theBrutzler/HDMI_to_TTL/3D_Pictures/HDMI_example.png

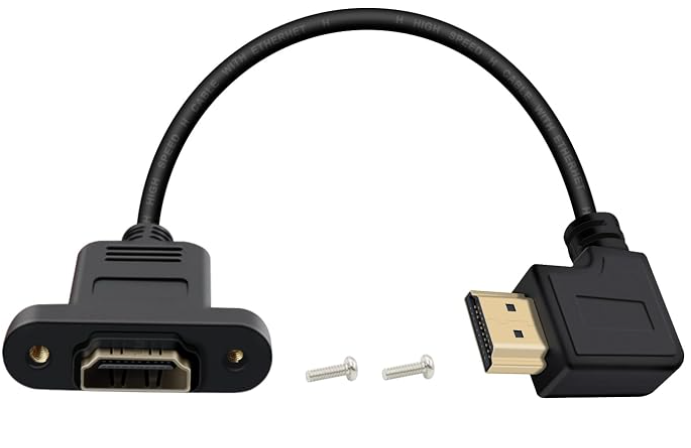
3D_Pictures/HDMI_example.png
