theBrutzler/HDMI_to_TTL/TTL_to_HDMI_DISPLAY.step

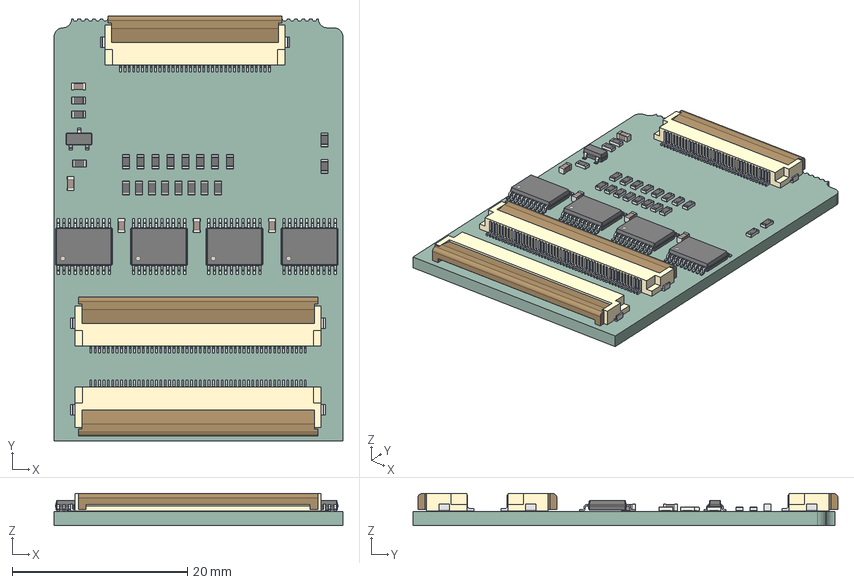
[picture p19: CAD file, 2026-10-30]
TTL_to_HDMI_DISPLAY.step
33.0 x 48.6 x 3.66 mm
C_0603_1608Metric x 5
TSSOP-20_4.4x6.5mm_P0.65mm x 4
R_0603_1608Metric x 21
lock x 3
pins x 3
SOT-23
TTL6087_PCB
