theBrutzler/HDMI_to_TTL/FH12-32S-0.5SH--3DModel-STEP-1.STEP

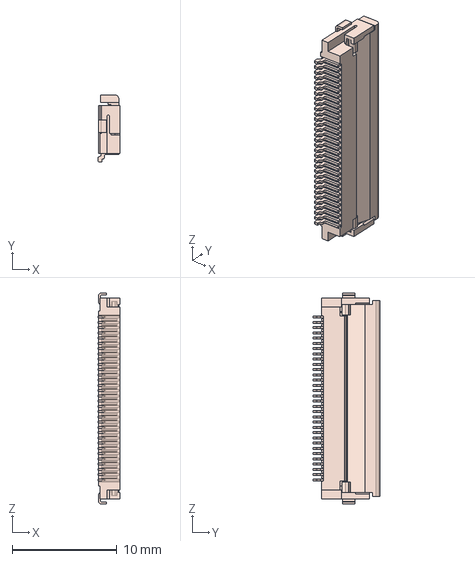
[picture p20: CAD file, 2024-02-11]
FH12-32S-0.5SH--3DModel-STEP-1.STEP
2.10 x 6.40 x 20.1 mm
