theBrutzler/HDMI_to_TTL/5-1734592-0.stp

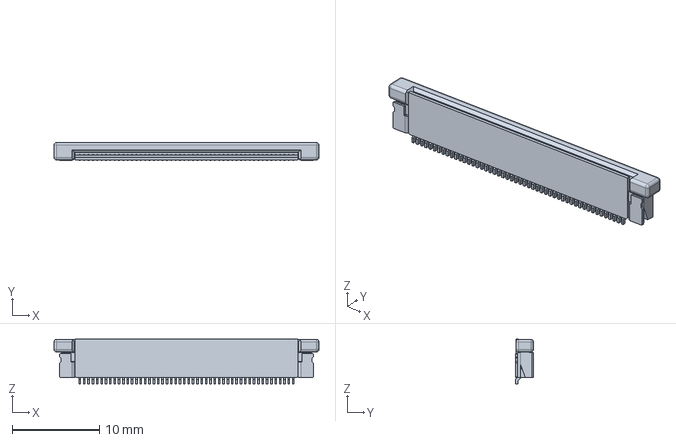
[picture p21: CAD file, 2022-11-29]
5-1734592-0.stp
30.4 x 2.05 x 5.11 mm
