theBrutzler/HDMI_to_TTL/Archiv/ds1000z_mainboard.step

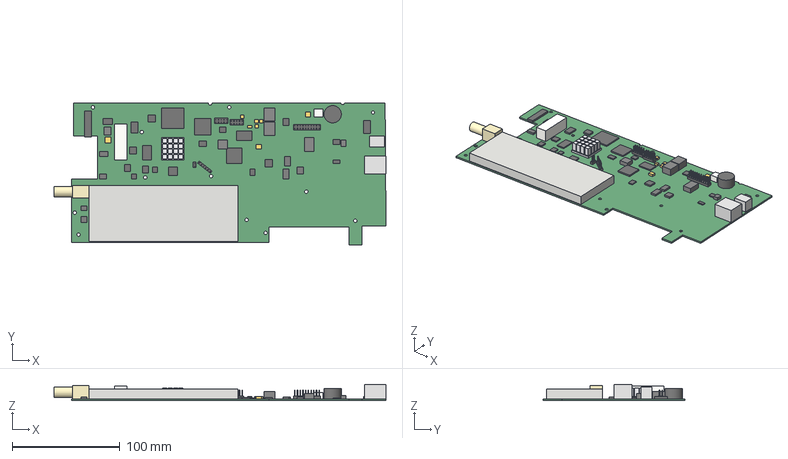
[picture p22: CAD file, 2026-10-31, an earlier design]
Archiv/ds1000z_mainboard.step
308.6 x 132.0 x 15.1 mm
PCB
IC1
IC2
IC3
IC4
IC5
IC6
IC7
IC8
IC9
IC10
IC11
IC12
IC13
IC14
IC15
IC16
IC17
IC18
IC19
IC20
IC21
REG1
REG2
REG3
REG4
REG5
REG6
REG7
C1
C2
C3
C4
C5
C6
C7
C8
L1
L2
L3
L4
L5
L6
HS_base
HS_fin00
HS_fin01
HS_fin02
HS_fin03
HS_fin10
HS_fin11
HS_fin12
HS_fin13
HS_fin20
HS_fin21
HS_fin22
HS_fin23
HS_fin30
HS_fin31
HS_fin32
HS_fin33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
