theBrutzler/HDMI_to_TTL/Archiv/ds1000z_front.step

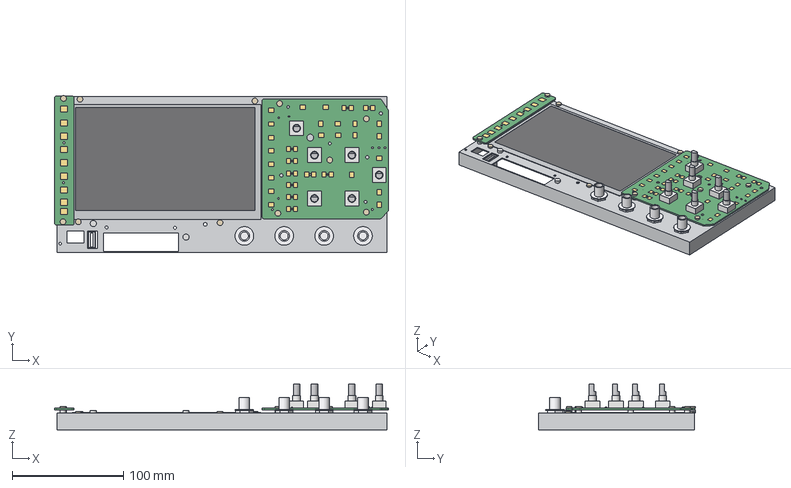
[picture p23: CAD file, 2026-11-03, an earlier design]
Archiv/ds1000z_front.step
300.8 x 141.3 x 41.1 mm
CHASSIS
PEM1
PEM2
LCD_FRAME
LCD_SCREEN
LCD_FPC
KEYBOARD_B
B_K5
B_K12
B_K13
B_K11
B_K9
B_K2
B_K4
B_K3
B_K1
KEYBOARD_A
A_K17
A_K19
A_K23
A_K18
A_K39
A_K34
A_K35
A_K38
A_K21
A_K20
A_K15
A_K28
A_K14
A_K7
A_K31
A_K6
A_K24
A_K33
A_K37
A_K40
A_K36
A_K8
A_K25_D38_padL
A_K25_D38_padR
A_D38
A_K22_LED9_padL
A_K22_LED9_padR
A_LED9
A_K27_LED2_padL
A_K27_LED2_padR
A_LED2
A_K26_LED3_padL
A_K26_LED3_padR
A_LED3
A_K10_LED4_padL
A_K10_LED4_padR
A_LED4
A_K41_LED5_padL
A_K41_LED5_padR
A_LED5
A_K32_LED6_padL
A_K32_LED6_padR
A_LED6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
