theBrutzler/HDMI_to_TTL/(list of files, cad)

Other CAD files:
TTL_to_HDMI_komplett.step
TTL_to_HDMI_FPGA.step
Archiv/TTL_to_HDMI.step
