theBrutzler/HDMI_to_TTL/Schematic.pdf

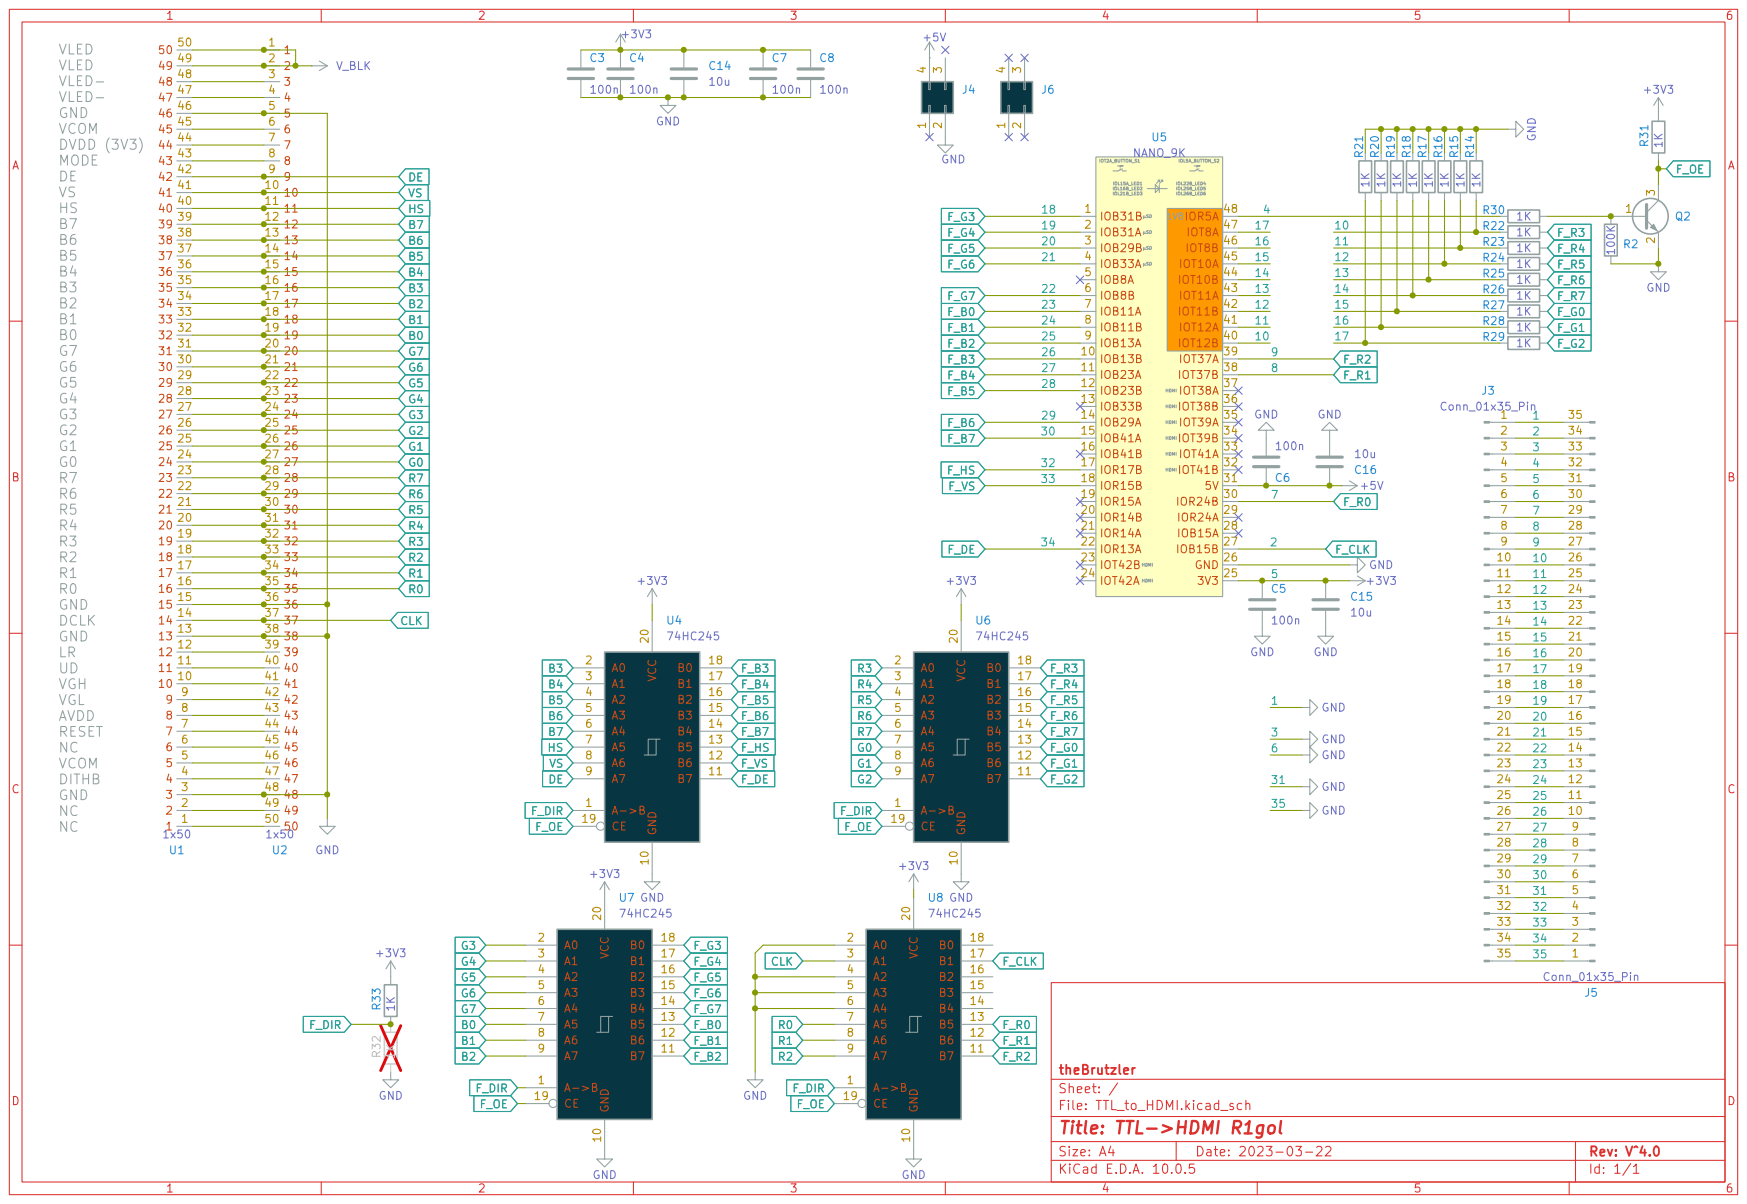
[picture p24: page 1]
