theBrutzler/HDMI_to_TTL/TTL_to_HDMI.pdf

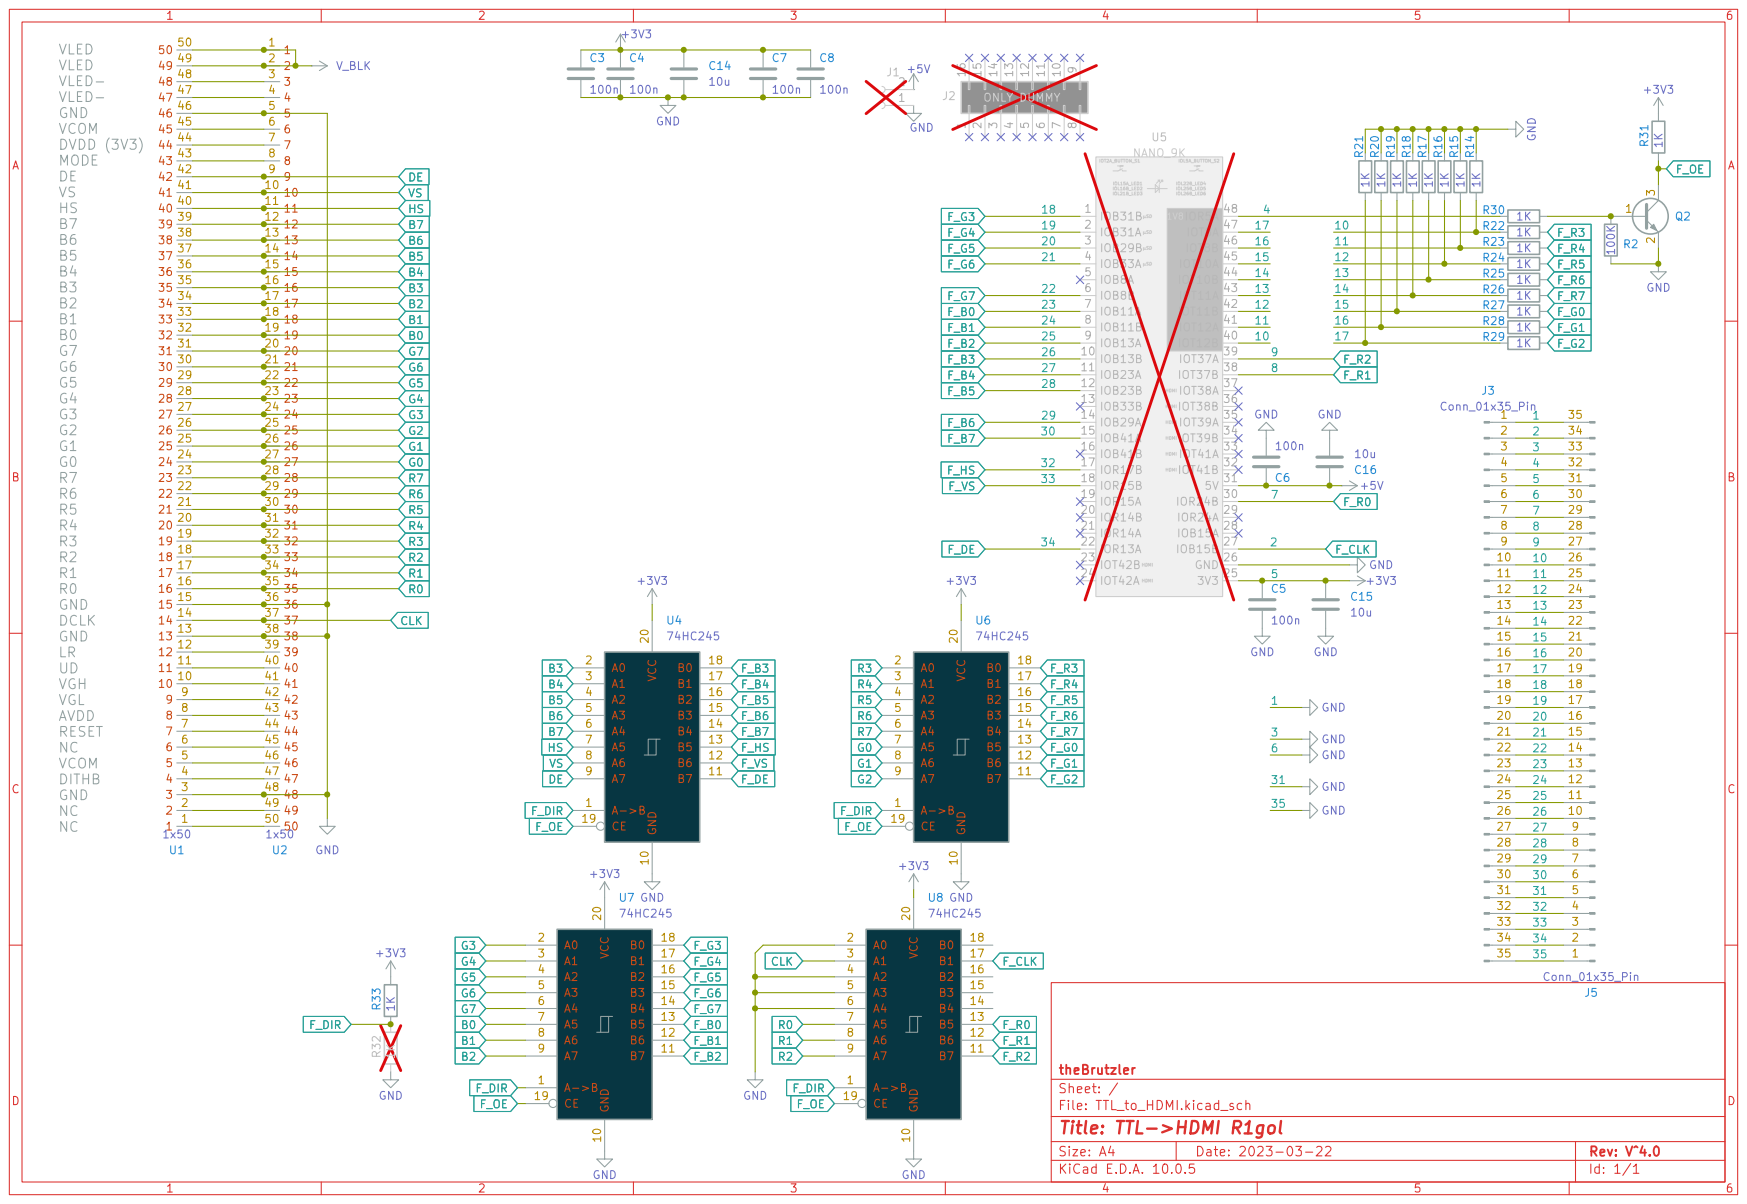
[picture p25: page 1]
