theBrutzler/HDMI_to_TTL/TTL_to_HDMI.kicad_pcb

## KiCad design TTL_to_HDMI.kicad_pcb (2026-10-30)

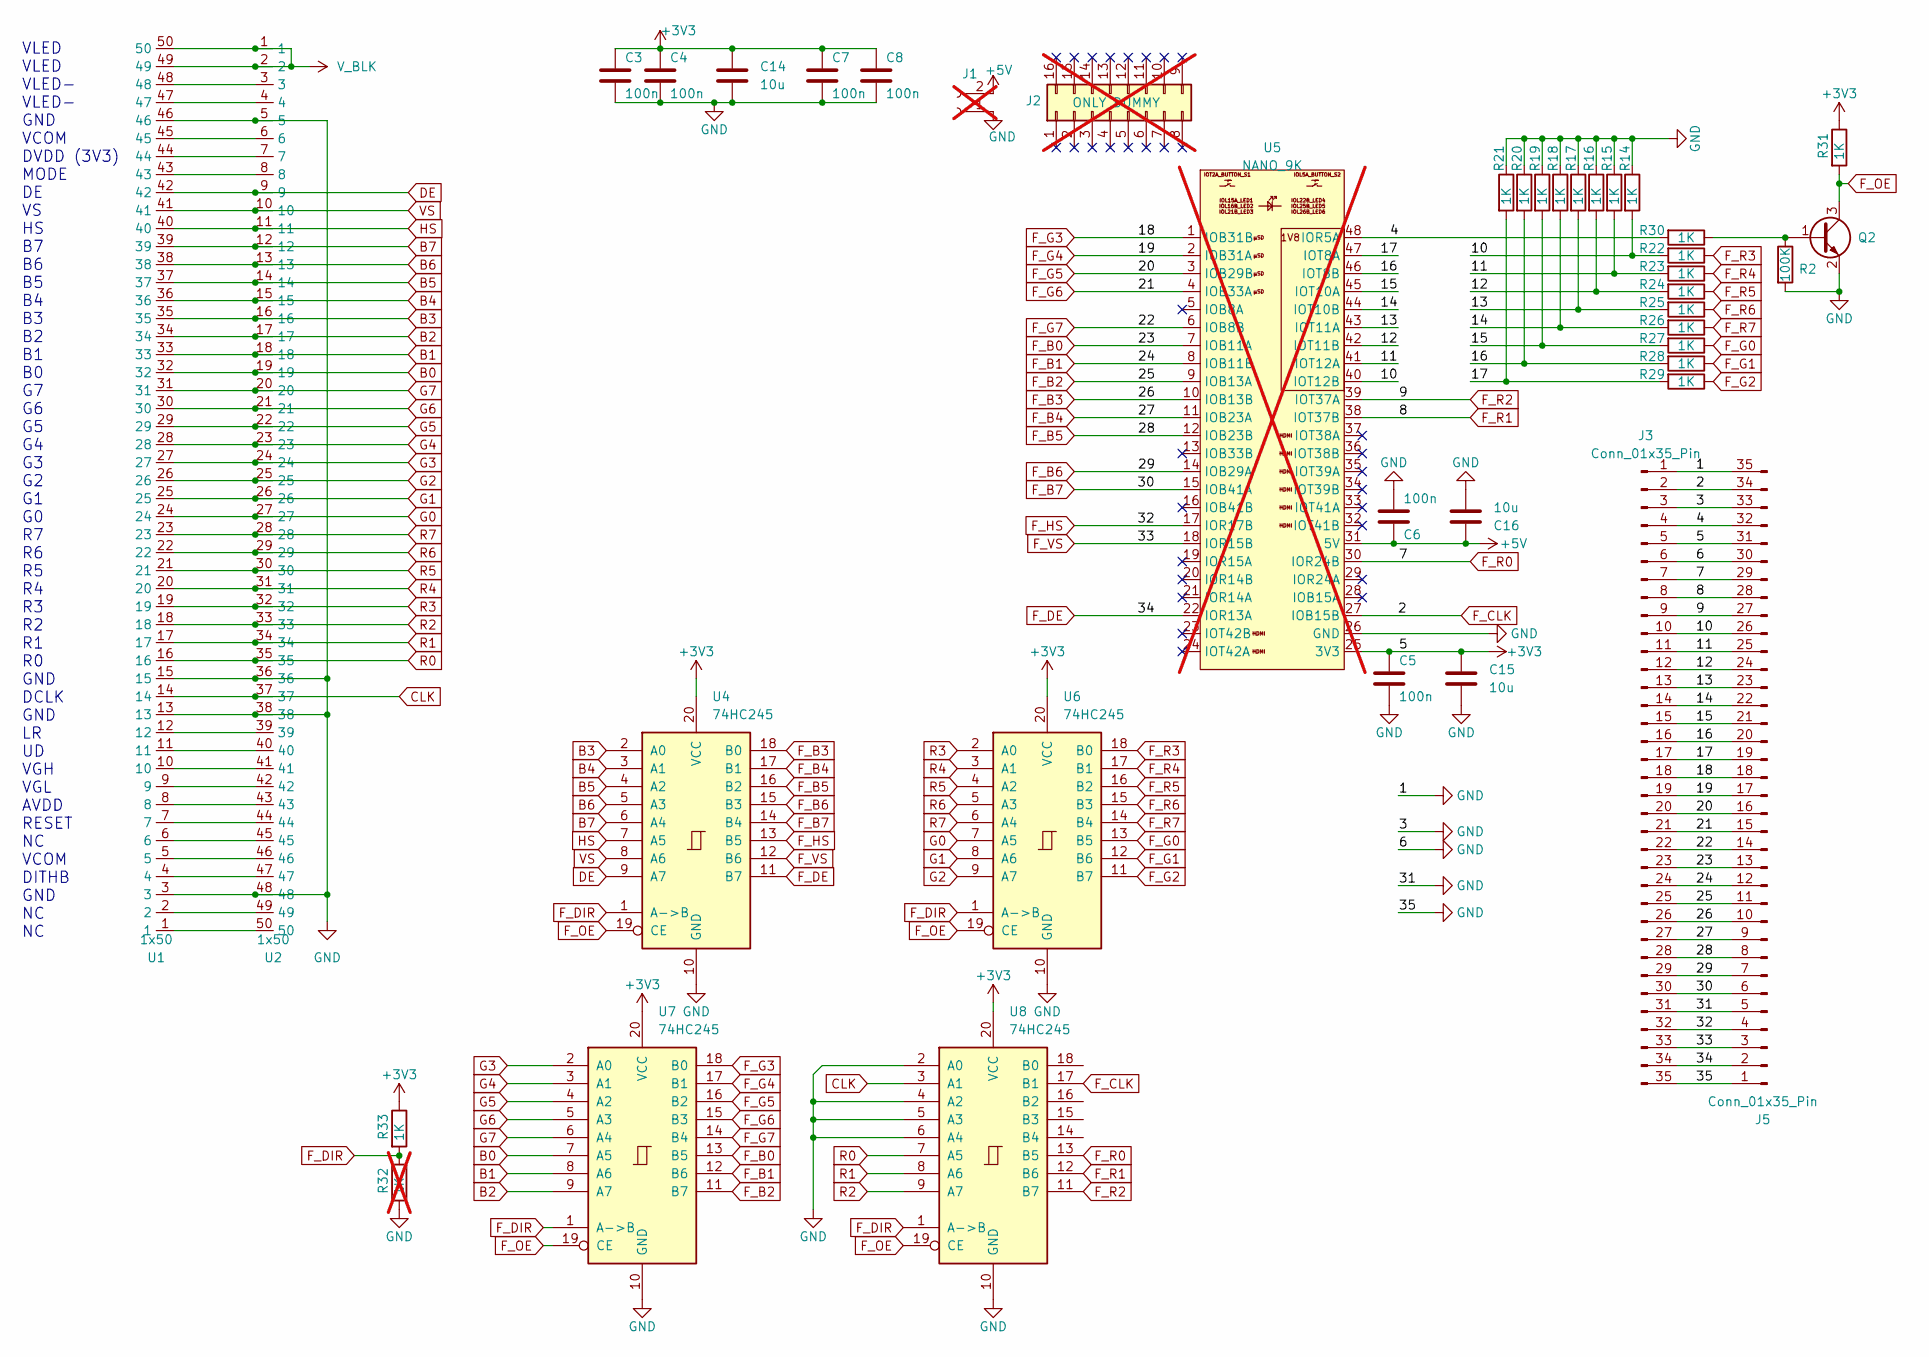
[picture p26: schematic TTL_to_HDMI.kicad_sch, TTL->HDMI R1gol]

Parts:
C3, C4, C5, C6, C7, C8: 100n; C_0603_1608Metric; LCSC C6119883
C14, C15, C16: 10u; C_0603_1608Metric; LCSC Part C6119842
J1: Conn_01x02_Socket; PinHeader_1x02_P2.54mm_Vertical; LCSC DNP; not fitted
J2: ONLY DUMMY; PinHeader_2x09_P2.54mm_Vertical; LCSC DNP; not fitted
J3, J5: Conn_01x35_Pin; Amphenol_F32Q-1A7x1-11035_1x35-1MP_P0.5mm_Horizontal; LCSC C2932729
Q2: Q_NPN_BEC; SOT-23; LCSC C181167
R2: 100K; R_0603_1608Metric; LCSC C54920958
R14, R15, R16, R17, R18, R19, R20, R21, R22, R23, R24, R25, R26, R27, R28, R29, R30, R31, R33: 1K; R_0603_1608Metric; LCSC C54920984
R32: 1K; R_0603_1608Metric; LCSC C54920984; not fitted
U1, U2: 1x50; Hirose_FH12-50S-0.5SH_1x50-1MP_P0.50mm_Horizontal; LCSC C22459571
U4, U6, U7, U8: 74HC245; TSSOP-20_4.4x6.5mm_P0.65mm; LCSC C53436307
U5: NANO_9K; Nano 9K; LCSC DNP; not fitted

Connections:
+3V3: C3.2, C4.2, C5.2, C7.2, C8.2, C14.1, C15.1, J3.5, J5.31, R31.1, R33.1, U4.20 (VCC), U5.25 (3V3), U6.20 (VCC), U7.20 (VCC), U8.20 (VCC)
+5V: C6.2, C16.1, J1.2, U5.31 (5V)
/4: J3.4, J5.32, R30.2, U5.48 (IOR5A)
/10: J3.10, J5.26, R14.2, R22.2, U5.40 (IOT12B)
/11: J3.11, J5.25, R15.2, R23.2, U5.41 (IOT12A)
/12: J3.12, J5.24, R16.2, R24.2, U5.42 (IOT11B)
/13: J3.13, J5.23, R17.2, R25.2, U5.43 (IOT11A)
/14: J3.14, J5.22, R18.2, R26.2, U5.44 (IOT10B)
/15: J3.15, J5.21, R19.2, R27.2, U5.45 (IOT10A)
/16: J3.16, J5.20, R20.2, R28.2, U5.46 (IOT8B)
/17: J3.17, J5.19, R21.2, R29.2, U5.47 (IOT8A)
B0: U1.32, U2.19, U7.7 (A5)
B1: U1.33, U2.18, U7.8 (A6)
B2: U1.34, U2.17, U7.9 (A7)
B3: U1.35, U2.16, U4.2 (A0)
B4: U1.36, U2.15, U4.3 (A1)
B5: U1.37, U2.14, U4.4 (A2)
B6: U1.38, U2.13, U4.5 (A3)
B7: U1.39, U2.12, U4.6 (A4)
CLK: U1.14, U2.37, U8.3 (A1)
DE: U1.42, U2.9, U4.9 (A7)
F_B0: J3.23, J5.13, U5.7 (IOB11A), U7.13 (B5)
F_B1: J3.24, J5.12, U5.8 (IOB11B), U7.12 (B6)
F_B2: J3.25, J5.11, U5.9 (IOB13A), U7.11 (B7)
F_B3: J3.26, J5.10, U4.18 (B0), U5.10 (IOB13B)
F_B4: J3.27, J5.9, U4.17 (B1), U5.11 (IOB23A)
F_B5: J3.28, J5.8, U4.16 (B2), U5.12 (IOB23B)
F_B6: J3.29, J5.7, U4.15 (B3), U5.14 (IOB29A)
F_B7: J3.30, J5.6, U4.14 (B4), U5.15 (IOB41A)
F_CLK: J3.2, J5.34, U5.27 (IOB15B), U8.17 (B1)
F_DE: J3.34, J5.2, U4.11 (B7), U5.22 (IOR13A)
F_DIR: R32.1, R33.2, U4.1 (A->B), U6.1 (A->B), U7.1 (A->B), U8.1 (A->B)
F_G0: R27.1, U6.13 (B5)
F_G1: R28.1, U6.12 (B6)
F_G2: R29.1, U6.11 (B7)
F_G3: J3.18, J5.18, U5.1 (IOB31B), U7.18 (B0)
F_G4: J3.19, J5.17, U5.2 (IOB31A), U7.17 (B1)
F_G5: J3.20, J5.16, U5.3 (IOB29B), U7.16 (B2)
F_G6: J3.21, J5.15, U5.4 (IOB33A), U7.15 (B3)
F_G7: J3.22, J5.14, U5.6 (IOB8B), U7.14 (B4)
F_HS: J3.32, J5.4, U4.13 (B5), U5.17 (IOR17B)
F_OE: Q2.3 (C), R31.2, U4.19 (CE), U6.19 (CE), U7.19 (CE), U8.19 (CE)
F_R0: J3.7, J5.29, U5.30 (IOR24B), U8.13 (B5)
F_R1: J3.8, J5.28, U5.38 (IOT37B), U8.12 (B6)
F_R2: J3.9, J5.27, U5.39 (IOT37A), U8.11 (B7)
F_R3: R22.1, U6.18 (B0)
F_R4: R23.1, U6.17 (B1)
F_R5: R24.1, U6.16 (B2)
F_R6: R25.1, U6.15 (B3)
F_R7: R26.1, U6.14 (B4)
F_VS: J3.33, J5.3, U4.12 (B6), U5.18 (IOR15B)
G0: U1.24, U2.27, U6.7 (A5)
G1: U1.25, U2.26, U6.8 (A6)
G2: U1.26, U2.25, U6.9 (A7)
G3: U1.27, U2.24, U7.2 (A0)
G4: U1.28, U2.23, U7.3 (A1)
G5: U1.29, U2.22, U7.4 (A2)
G6: U1.30, U2.21, U7.5 (A3)
G7: U1.31, U2.20, U7.6 (A4)
GND: C3.1, C4.1, C5.1, C6.1, C7.1, C8.1, C14.2, C15.2, C16.2, J1.1, J3.1, J3.3, J3.6, J3.31, J3.35, J5.1, J5.5, J5.30, J5.33, J5.35, Q2.2 (E), R2.2, R14.1, R15.1, R16.1, R17.1, R18.1, R19.1, R20.1, R21.1, R32.2, U1.3, U1.13, U1.15, U1.46, U2.5, U2.36, U2.38, U2.48, U4.10 (GND), U5.26 (GND), U6.10 (GND), U7.10 (GND), U8.2 (A0), U8.4 (A2), U8.5 (A3), U8.6 (A4), U8.10 (GND)
HS: U1.40, U2.11, U4.7 (A5)
unnamed: Q2.1 (B), R2.1, R30.1
unnamed: U1.1, U2.50
unnamed: U1.2, U2.49
unnamed: U1.4, U2.47
unnamed: U1.5, U2.46
unnamed: U1.6, U2.45
unnamed: U1.7, U2.44
unnamed: U1.8, U2.43
unnamed: U1.9, U2.42
unnamed: U1.10, U2.41
unnamed: U1.11, U2.40
unnamed: U1.12, U2.39
unnamed: U1.43, U2.8
unnamed: U1.44, U2.7
unnamed: U1.45, U2.6
unnamed: U1.47, U2.4
unnamed: U1.48, U2.3
R0: U1.16, U2.35, U8.7 (A5)
R1: U1.17, U2.34, U8.8 (A6)
R2: U1.18, U2.33, U8.9 (A7)
R3: U1.19, U2.32, U6.2 (A0)
R4: U1.20, U2.31, U6.3 (A1)
R5: U1.21, U2.30, U6.4 (A2)
R6: U1.22, U2.29, U6.5 (A3)
R7: U1.23, U2.28, U6.6 (A4)
VS: U1.41, U2.10, U4.8 (A6)
V_BLK: U1.49, U1.50, U2.1, U2.2

Notes on the sheet:
VLED VLED VLED- VLED- GND VCOM DVDD (3V3) MODE DE VS HS B7 B6 B5 B4 B3 B2 B1 B0 G7 G6 G5 G4 G3 G2 G1 G0 R7 R6 R5 R4 R3 R2 R1 R0 GND DCLK GND LR UD VGH VGL AVDD RESET NC VCOM DITHB GND NC NC

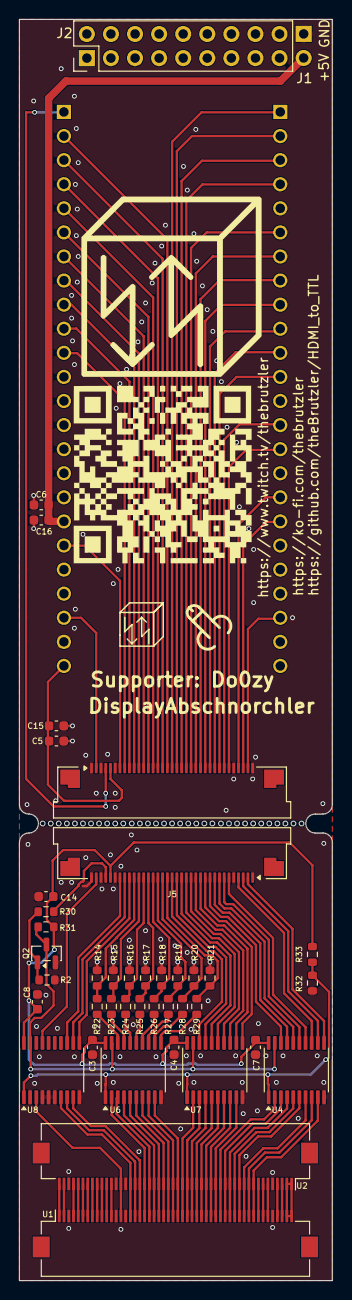
[picture p27: board TTL_to_HDMI.kicad_pcb from above]

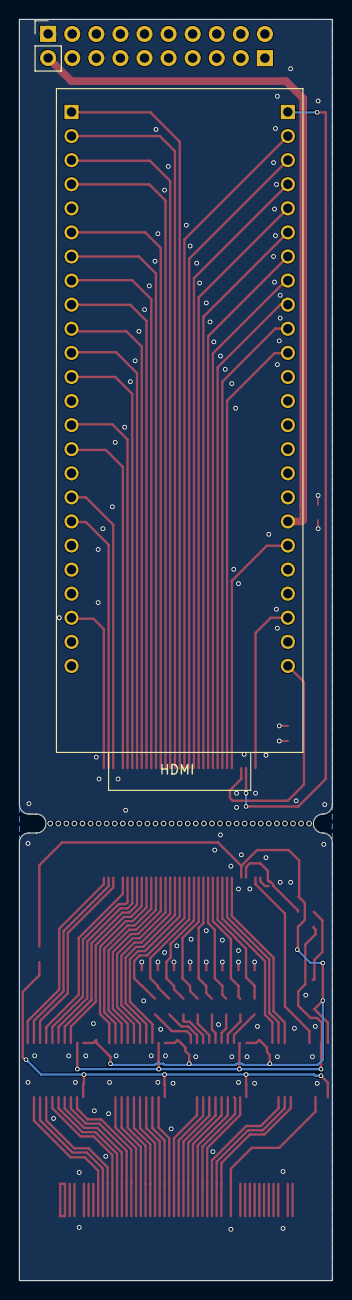
[picture p28: board TTL_to_HDMI.kicad_pcb from below]

Board: 2 copper layers, 33.0 x 133.0 mm, 43 parts (2 on the bottom side), 88 nets.

Other parts of the board:
SM3: SYM_Arrow45_Tiny; Symbol_kurzschlussblog
