theBrutzler/HDMI_to_TTL/TTL_to_HDMI_.kicad_pcb

## KiCad design TTL_to_HDMI_.kicad_pcb (2024-02-11)

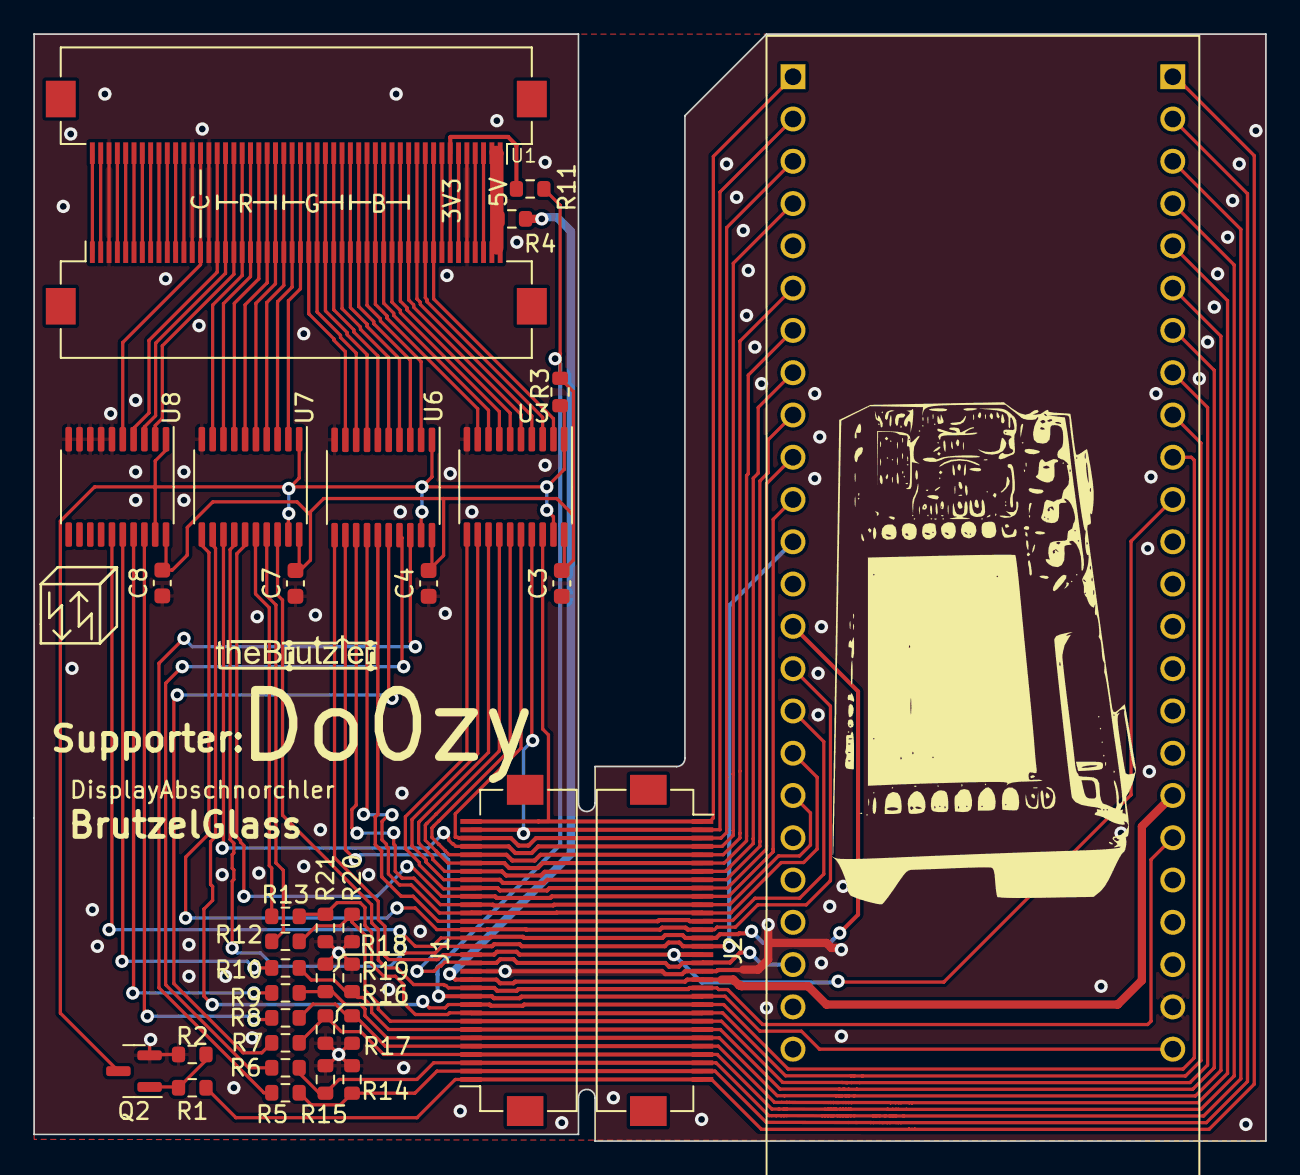
[picture p29: board TTL_to_HDMI_.kicad_pcb from above]

Board: 2 copper layers, 74.0 x 66.5 mm, 36 parts (0 on the bottom side), 87 nets.

Parts:
C3, C4, C7, C8: 100n; C_0603_1608Metric
J1, J2: Conn_01x32_Pin; Hirose_FH12-32S-0.5SH_1x32-1MP_P0.50mm_Horizontal
Q2: Q_NPN_BEC; SOT-23
R1, R3, R5, R6, R7, R8, R9, R10, R12, R13, R14, R15, R16, R17, R18, R19, R20, R21: 10K; R_0603_1608Metric
R2: 100K; R_0603_1608Metric
R4, R11: 0; R_0603_1608Metric
SM3: SYM_Arrow45_Tiny; Symbol_kurzschlussblog
U1, U2: 1x50; Hirose_FH12-50S-0.5SH_1x50-1MP_P0.50mm_Horizontal
U3, U6, U7, U8: 74LVX541; TSSOP-20_4.4x6.5mm_P0.65mm
U5: NANO_9K; Nano 9K

Connections:
+3V3: C3.2, C4.2, C7.2, C8.2, J1.11, J2.22, R3.1, R11.2, U3.20 (VCC), U5.25 (3V3), U6.20 (VCC), U7.20 (VCC), U8.20 (VCC)
+5V: J1.13, J2.20, R4.2, U5.31 (5V)
/24: J1.9, J2.24, R13.2, R21.2, U5.40 (IOT12B)
/25: J1.8, J2.25, R12.2, R20.2, U5.41 (IOT12A)
/26: J1.7, J2.26, R10.2, R19.2, U5.42 (IOT11B)
/27: J1.6, J2.27, R9.2, R18.2, U5.43 (IOT11A)
/28: J1.5, J2.28, R8.2, R17.2, U5.44 (IOT10B)
/29: J1.4, J2.29, R7.2, R16.2, U5.45 (IOT10A)
/30: J1.3, J2.30, R6.2, R15.2, U5.46 (IOT8B)
/31: J1.2, J2.31, R5.2, R14.2, U5.47 (IOT8A)
/32: J1.1, J2.32, R1.2, U5.48 (IOR5A)
B0: U1.19, U2.32, U6.4 (A2)
B1: U1.18, U2.33, U6.3 (A1)
B2: U1.17, U2.34, U6.2 (A0)
B3: U1.16, U2.35, U3.9 (A7)
B4: U1.15, U2.36, U3.8 (A6)
B5: U1.14, U2.37, U3.7 (A5)
B6: U1.13, U2.38, U3.6 (A4)
B7: U1.12, U2.39, U3.5 (A3)
CLK: U1.37, U2.14, U8.5 (A3)
DE: U1.9, U2.42, U3.2 (A0)
F_B0: R7.1, U6.16 (Y2)
F_B1: R6.1, U6.17 (Y1)
F_B2: R5.1, U6.18 (Y0)
F_B3: J1.24, J2.9, U3.11 (Y7), U5.10 (IOB13B)
F_B4: J1.25, J2.8, U3.12 (Y6), U5.9 (IOB13A)
F_B5: J1.26, J2.7, U3.13 (Y5), U5.8 (IOB11B)
F_B6: J1.27, J2.6, U3.14 (Y4), U5.7 (IOB11A)
F_B7: J1.28, J2.5, U3.15 (Y3), U5.6 (IOB8B)
F_CLK: J1.18, J2.15, U5.14 (IOB29A), U8.15 (Y3)
F_DE: J1.32, J2.1, U3.18 (Y0), U5.1 (IOB31B)
F_G0: R13.1, U7.16 (Y2)
F_G1: R12.1, U7.17 (Y1)
F_G2: J1.12, J2.21, U5.30 (IOR24B), U7.18 (Y0)
F_G3: J1.16, J2.17, U5.38 (IOT37B), U6.11 (Y7)
F_G4: J1.15, J2.18, U5.22 (IOR13A), U6.12 (Y6)
F_G5: J1.22, J2.11, U5.18 (IOR15B), U6.13 (Y5)
F_G6: J1.21, J2.12, U5.17 (IOR17B), U6.14 (Y4)
F_G7: J1.20, J2.13, U5.16 (IOB41B), U6.15 (Y3)
F_HS: J1.30, J2.3, U3.16 (Y2), U5.3 (IOB29B)
F_OE1: Q2.3 (C), R3.2, U3.1 (G1), U3.19 (G2), U6.1 (G1), U6.19 (G2), U7.1 (G1), U7.19 (G2), U8.1 (G1), U8.19 (G2)
F_R0: R10.1, U8.16 (Y2)
F_R1: R9.1, U8.17 (Y1)
F_R2: R8.1, U8.18 (Y0)
F_R3: J1.19, J2.14, U5.15 (IOB41A), U7.11 (Y7)
F_R4: J1.10, J2.23, U5.39 (IOT37A), U7.12 (Y6)
F_R5: J1.29, J2.4, U5.4 (IOB33A), U7.13 (Y5)
F_R6: J1.17, J2.16, U5.12 (IOB23B), U7.14 (Y4)
F_R7: J1.23, J2.10, U5.11 (IOB23A), U7.15 (Y3)
F_VS: J1.31, J2.2, U3.17 (Y1), U5.2 (IOB31A)
G0: U1.27, U2.24, U7.4 (A2)
G1: U1.26, U2.25, U7.3 (A1)
G2: U1.25, U2.26, U7.2 (A0)
G3: U1.24, U2.27, U6.9 (A7)
G4: U1.23, U2.28, U6.8 (A6)
G5: U1.22, U2.29, U6.7 (A5)
G6: U1.21, U2.30, U6.6 (A4)
G7: U1.20, U2.31, U6.5 (A3)
GND: C3.1, C4.1, C7.1, C8.1, J1.14, J2.19, Q2.2 (E), R2.2, R14.1, R15.1, R16.1, R17.1, R18.1, R19.1, R20.1, R21.1, U1.5, U1.36, U1.38, U1.48, U2.3, U2.13, U2.15, U2.46, U3.10 (GND), U5.26 (GND), U6.10 (GND), U7.10 (GND), U8.6 (A4), U8.7 (A5), U8.8 (A6), U8.9 (A7), U8.10 (GND)
HS: U1.11, U2.40, U3.4 (A2)
unnamed: Q2.1 (B), R1.1, R2.1
unnamed: R4.1, U1.1, U1.2, U2.49, U2.50
unnamed: U1.3, U2.48
unnamed: U1.4, U2.47
unnamed: U1.6, U2.45
unnamed: U1.8, U2.43
unnamed: U1.39, U2.12
unnamed: U1.40, U2.11
unnamed: U1.41, U2.10
unnamed: U1.42, U2.9
unnamed: U1.43, U2.8
unnamed: U1.44, U2.7
unnamed: U1.45, U2.6
unnamed: U1.46, U2.5
unnamed: U1.47, U2.4
unnamed: U1.49, U2.2
unnamed: U1.50, U2.1
R0: U1.35, U2.16, U8.4 (A2)
R1: U1.34, U2.17, U8.3 (A1)
R2: U1.33, U2.18, U8.2 (A0)
R3: U1.32, U2.19, U7.9 (A7)
R4: U1.31, U2.20, U7.8 (A6)
R5: U1.30, U2.21, U7.7 (A5)
R6: U1.29, U2.22, U7.6 (A4)
R7: U1.28, U2.23, U7.5 (A3)
VCC: R11.1, U1.7, U2.44
VS: U1.10, U2.41, U3.3 (A1)
