theBrutzler/HDMI_to_TTL/(commit log)

2022-11-29 Initial Upload
    NOT WORKING!
    [5-1734592-0.stp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]
2022-12-04 Add kibot action to generate schematic
2024-02-11 Upload_V3 V4 and PDF V3
    [Analog_Devices.kicad_pcb, Analog_Devices.kicad_sch, FH12-32S-0.5SH--3DModel-STEP-1.STEP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]
2026-09-30 upload inital software
    These versions are working, but they are not perfect because the hardware TTL signals are not good enough.
    [device.cfg]
2026-10-08 update schematic
    schaltplan update
2026-11-03 add display FFC-Kabel 50-polig, Raster 0,5 mm
2026-11-03 update readme (HDMI cable)
2026-11-03 README: englische Übersetzung ergänzen
    Die Anleitung ist jetzt zweisprachig: Unter jedem deutschen Absatz,
    Listenpunkt, Hinweis und jeder Tabellenzelle steht die englische
    Übersetzung kursiv. Die Überschriften sind Deutsch / Englisch, die
    internen Sprungmarken sind entsprechend angepasst.
